mike-rankin/ESP32-C6_CO2_Monitor/Images/Component_Side.jpeg

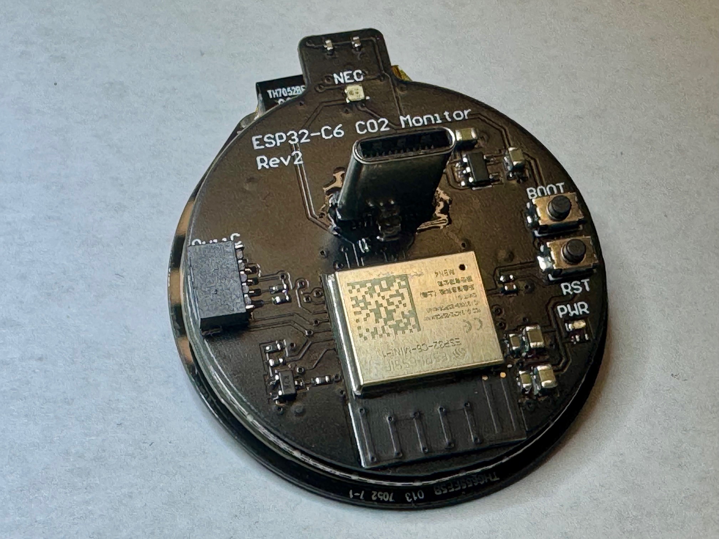
Images/Component_Side.jpeg
