mike-rankin/ESP32-C6_CO2_Monitor/Images/USB-C.jpeg

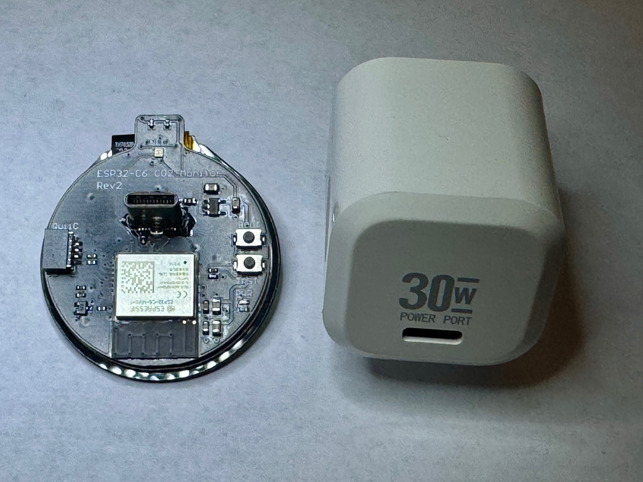
Images/USB-C.jpeg
