mike-rankin/ESP32-C6_CO2_Monitor/Images/0x44.jpg

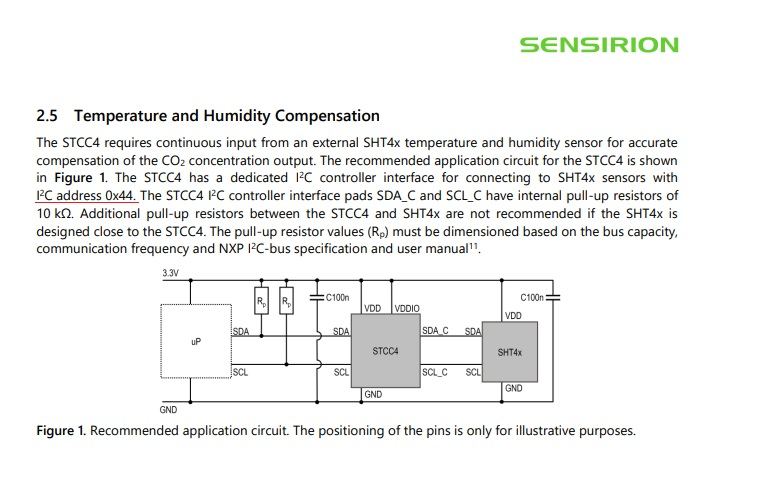
Images/0x44.jpg
