mike-rankin/ESP32-C6_CO2_Monitor/Images/Back.jpg

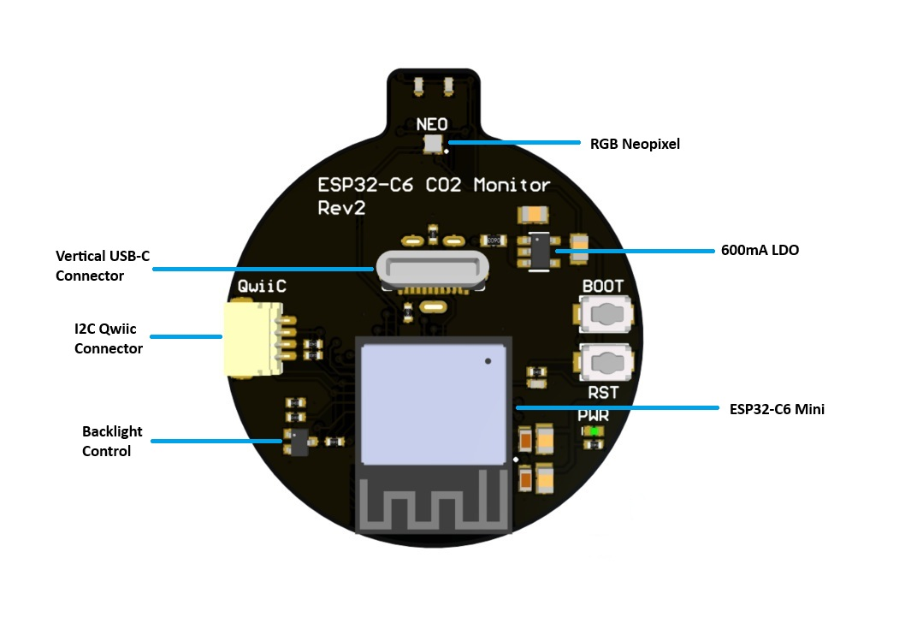
Images/Back.jpg
