mike-rankin/ESP32-C6_CO2_Monitor/Images/ESP_Tool_Flasher.jpg

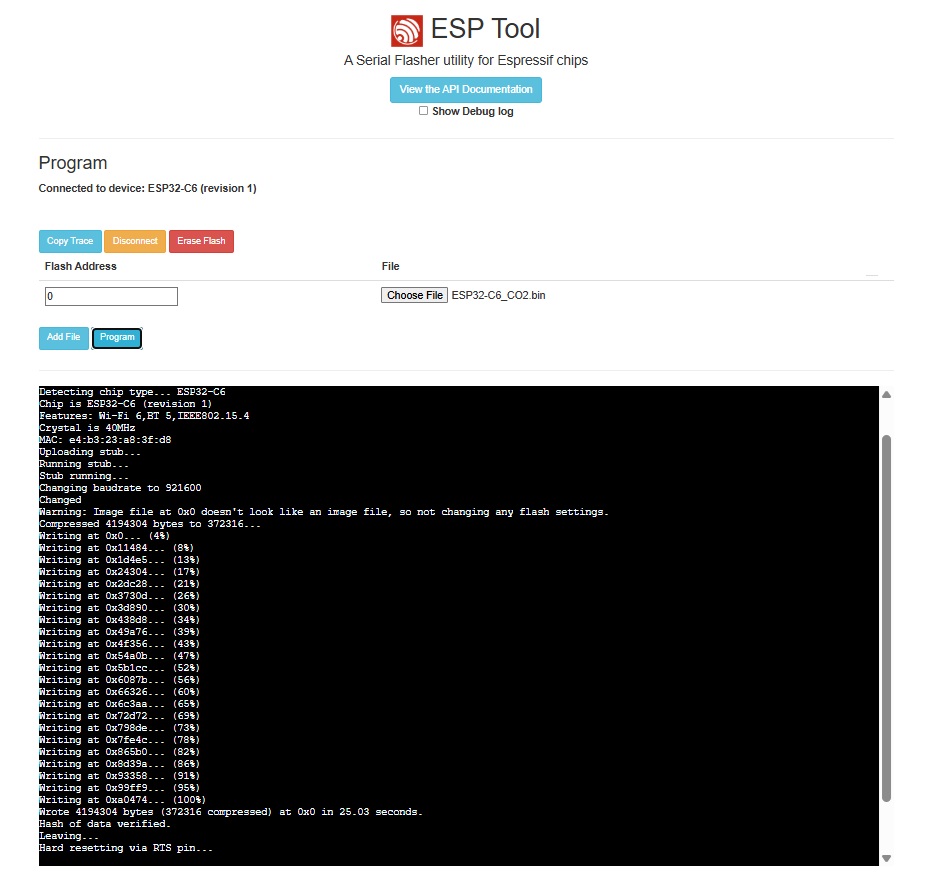
Images/ESP_Tool_Flasher.jpg
