mike-rankin/ESP32-C6_CO2_Monitor/Images/Footprint.jpeg

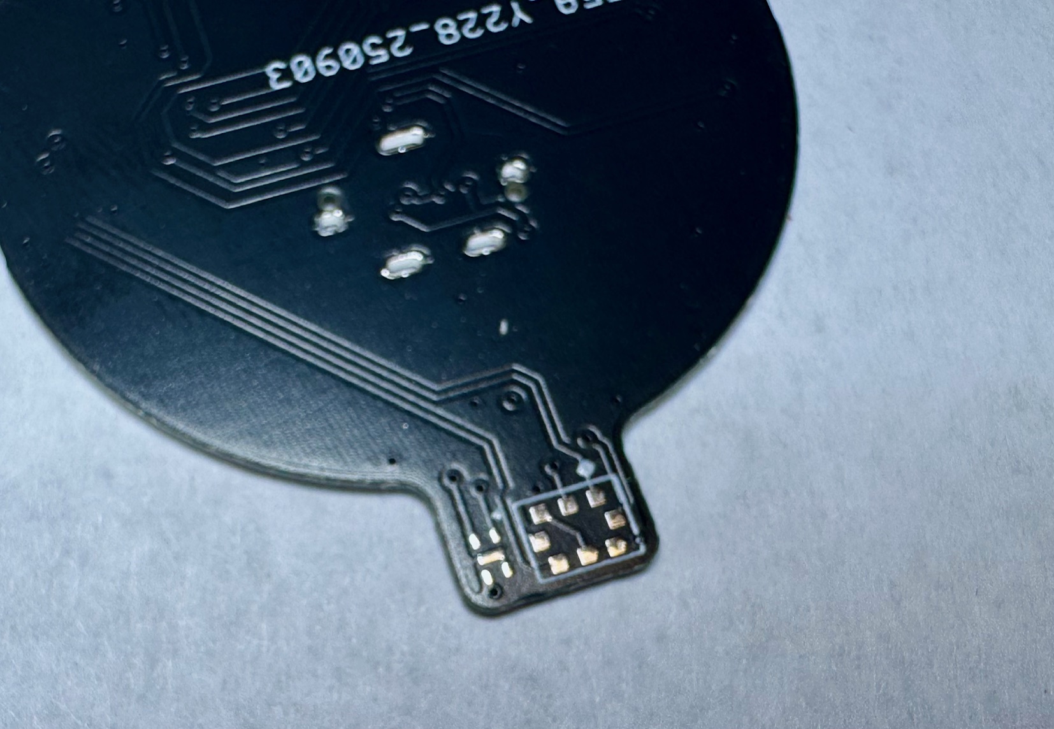
Images/Footprint.jpeg
