mike-rankin/ESP32-C6_CO2_Monitor/Images/Front.jpg

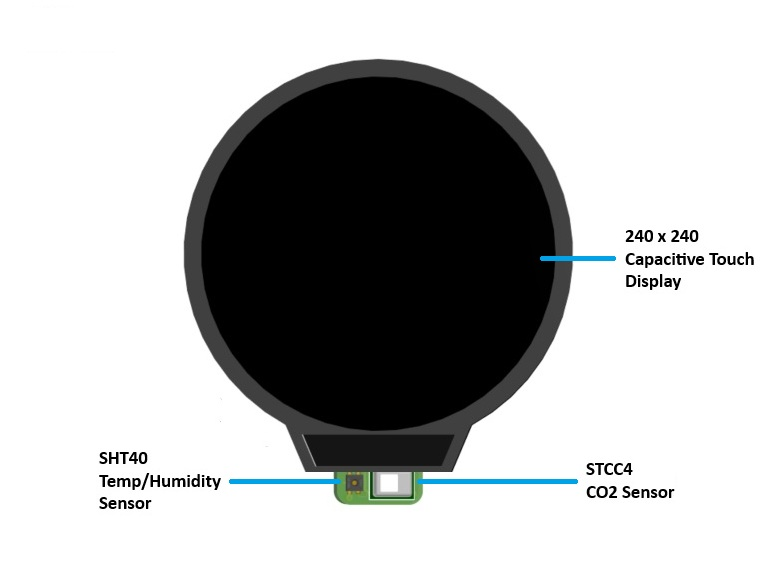
Images/Front.jpg
