mike-rankin/ESP32-C6_CO2_Monitor/Images/Sensors.jpeg

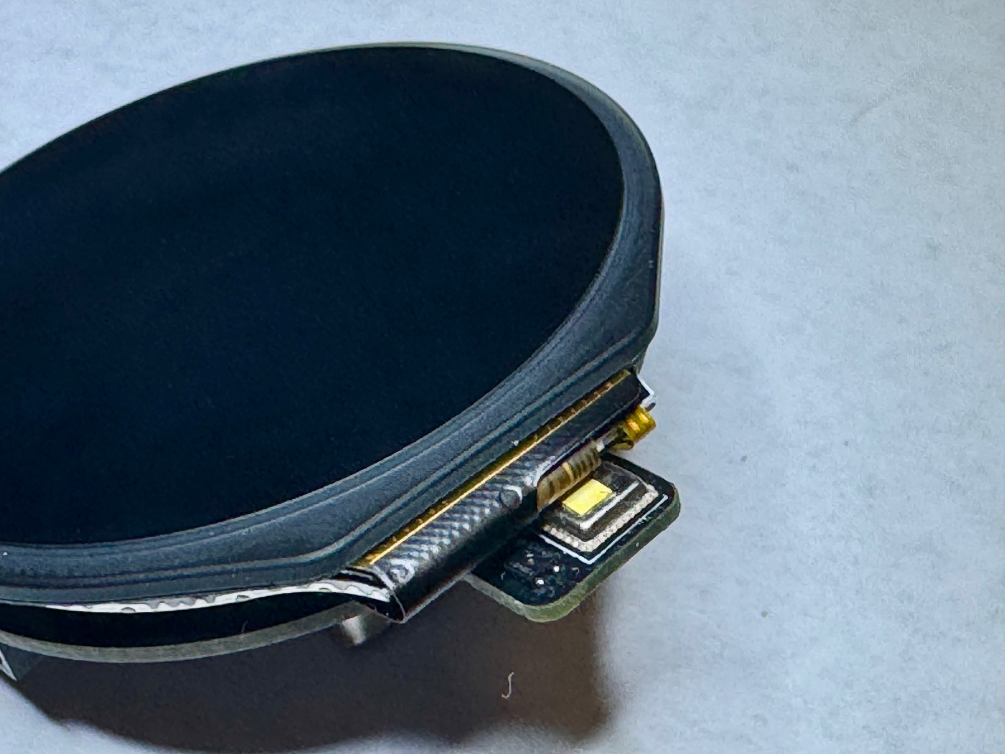
Images/Sensors.jpeg
