mike-rankin/ESP32-C6_CO2_Monitor/Images/SHT40.jpg

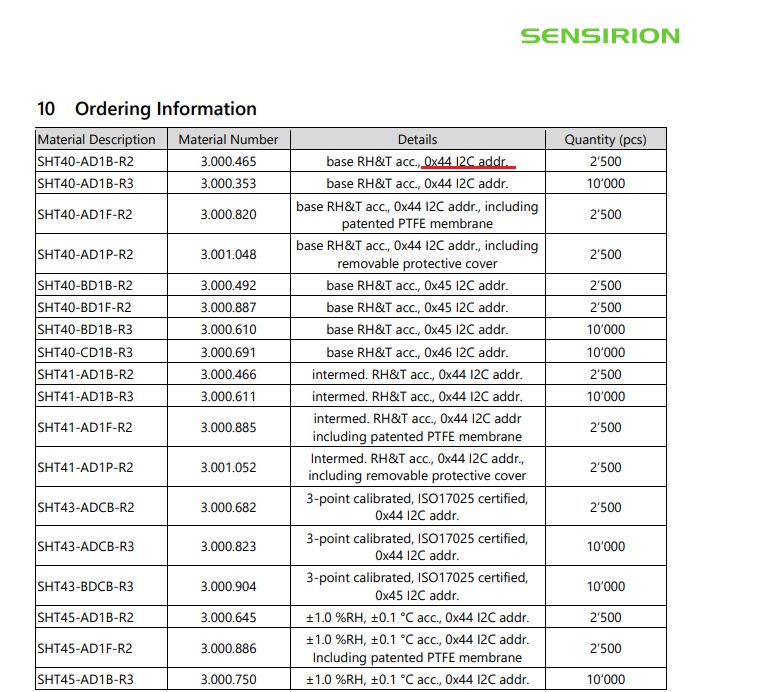
Images/SHT40.jpg
