mike-rankin/ESP32-C6_CO2_Monitor/PCB/BOM_Rev2.xlsx

Designator | Quantity | Vendor | Part_Number | Description | Manufacturer | Value
C1, C2, C3, C5 | 4 |  |  | CAP 10uF 50V 0805, CAP 10uF 0805 |  | 10uF
C4, C6, C8, C9 | 4 |  |  | CAP 0.1uF 0603, CAP 0.1uF 0402 |  | 0.1uF
C7 | 1 |  |  | CAP 1uF 0402 |  | 1uF
D1 | 1 | LCSC | C74338 | LED Green 0402 |  | Green Led
D2 | 1 | LCSC | C2909055 | LED,RGB,NEOPIXEL,SK6805-EC14 | OPSCO | NeoPixel
F1 | 1 | LCSC | C2982257 | PTC FUSE 0.5mA hold, 1A trip 0603 | JDT Fuse | PTC
H1 | 1 | LCSC | C19270571 | CONN HEADER 4POS .100 R/A QWIIC | HCTL | Qwiic
J1 | 1 | LCSC | GT-USB-8018B | CONN RECPT USB-C Vertical w/TH Mount | G-Switch | USB-C VERT
Q1 | 1 | LCSC | C54879 | TRANSISTOR NPN GP 40V SC-70 | Changjiang | MMST3904
R1 | 1 |  |  | RES 27K 0402 |  | 27K
R2, R3 | 2 |  |  | RES 5.1K 0402 |  | 5.1K
R4 | 1 |  |  | RES 10R 0402 |  | 10R
R5 | 1 |  |  | RES 1K 0402 |  | 1K
R6, R7 | 2 |  |  | RES 10K 0402 |  | 10K
R8, R9 | 2 |  |  | RES 2K 0402 |  | 2K
S1, S2 | 2 | Digi-Key | TL1015AF160QG | SWITCH MOMENTARY
U1 | 1 | LCSC | C841192 | IC LDO 3.3V 0.6A SOT23-5 | Richtek Tech | RT9080-33GJ5
U2 | 1 | LCSC | C5736265 | WIFI/Bluetooth, 4M Flash QFN-56 7x7 | Espressif | ESP32-C6-MINI-1-N4
U3 | 1 | Digi-Key | STCC4-D-R3 | CO2 SENSOR I2C SMD | Sensirion | STCC4
U4 | 1 | Digi-Key | SHT40-AD1B | Sensor Humidity/Temperature I2C SMD | Sensirion AG | SHT40
X1 | 1 | Digi-Key | BM10NB(0.8)-24DS-0.4V(51) | FFC, FPC 24 pin 0.4mm Connector for 1.28" TFT | Hirose | LCD Connector
X2 | 1 | BuyDisplay | ER-TFT1.28-2 | 1.28 INCH TFT GLASS ROUND | BuyDisplay | 1.28" Round LCD
