mike-rankin/ESP32-C6_CO2_Monitor/PCB/Schematic_Rev2.pdf

VBUS | B4 VBUS | A9 GND B¹ GND A¹² | GND TAB

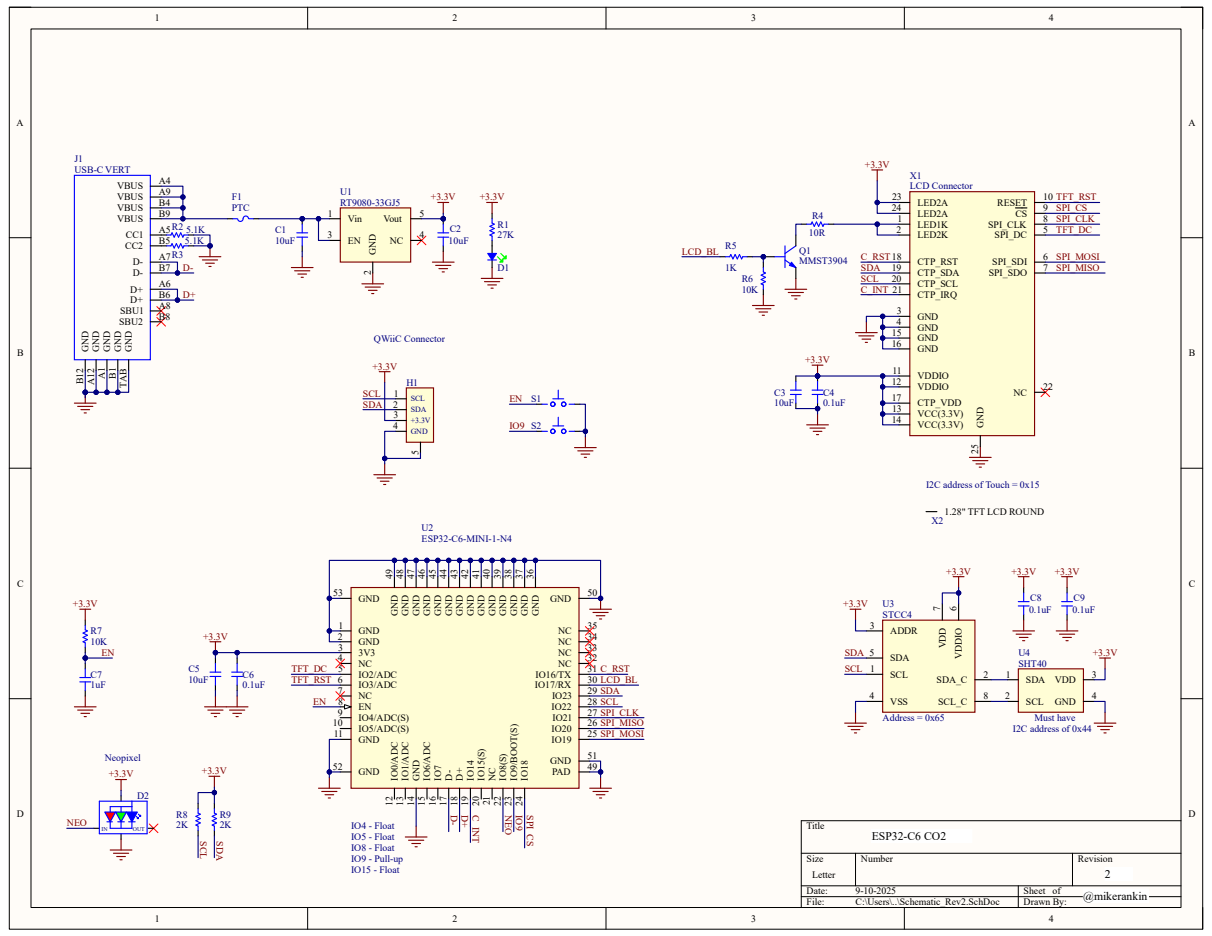
[picture p10: page 1]

U1 GND A¹ GND B¹²
